MicrosystemsLab/PressureController/PrsCtrl_UI/waveform_list_all.txt

Waveform List
Constant,0 Hz,0 kPa,25 kPa,0 %,0.1 min
Sinusoid,1 Hz,5 kPa,25 kPa,0 %,0.1 min
Square,1 Hz,5 kPa,25 kPa,33 %,0.1 min
Ramp,1 Hz,5 kPa,25 kPa,0 %,0.1 min
