MicrosystemsLab/PressureController/system_diagram.png

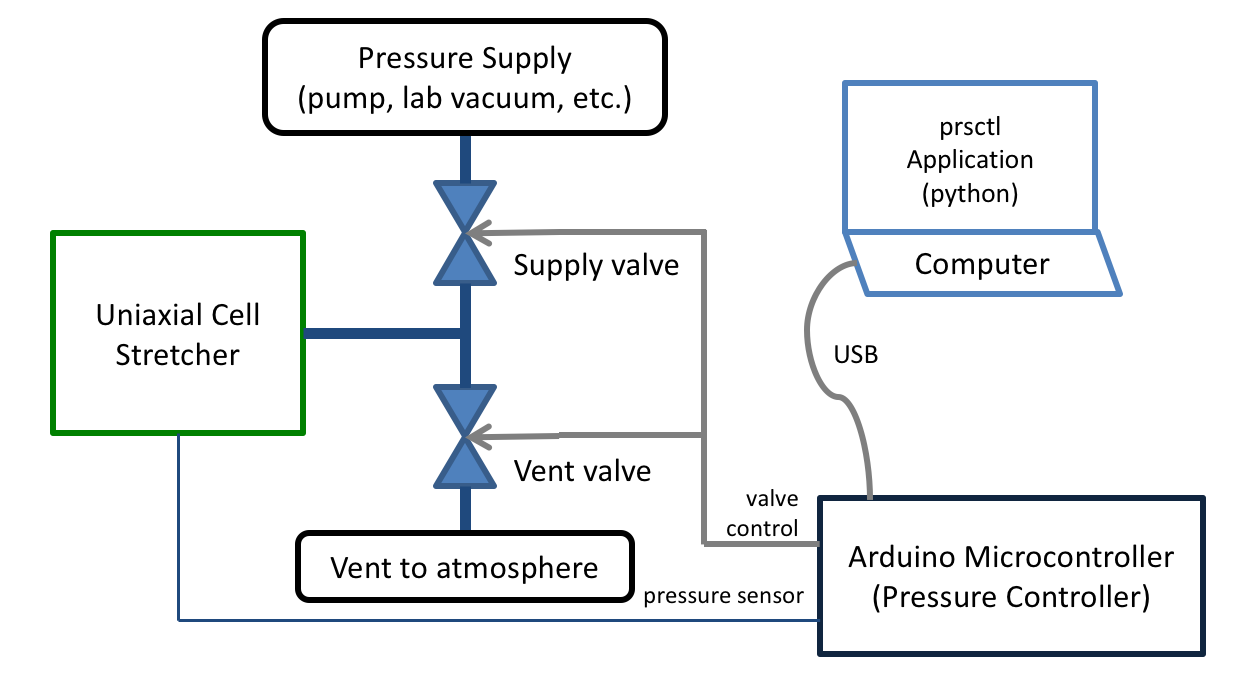
system_diagram.png
