MicrosystemsLab/PressureController/Circuit_Board/PC2_BOM.pdf

## Pressure Controller 2 BOM

Quantity | Image | Part Number | Description

Not included here: DC power supply (2.1 mm plug) and Arduino Uno microcontroller.

1

S1011EC-40-ND | CONN HEADER .100" SNGL STR 40POS
1050-1003-ND | BOX PLASTIC BLK 3.43"L X 2.52"W

1

2 | 24QBK-ND | RES 24 OHM 1/4W 5% AXIAL

2

399-4354-ND | CAP CER 0.22UF 50V Z5U RADIAL
IRLZ34NPBF-ND | MOSFET N-CH 55V 30A TO-220AB
160-1705-ND | LED RED DIFF 5MM ROUND T/H
399-9877-1-ND | CAP CER 0.1UF 50V X7R RADIAL
445-5263-ND | CAP CER 0.33UF 50V X7R RADIAL
3 | 1N4933GOS-ND | DIODE GEN PURP 50V 1A DO41

1

430QBK-ND | RES 430 OHM 1/4W 5% AXIAL
1.0MQBK-ND | RES 1M OHM 1/4W 5% AXIAL
CP-102A-ND | CONN PWR JACK 2X5.5MM SOLDER
ED2580-ND | TERM BLOCK 5.08MM VERT 2POS PCB

1

1

480-4489-ND | SENSOR PRESS 15PSID ANALOG
CL220N5-G-ND | IC LED DRIVER 220V .02A 3TO-220
360-3243-ND | SWITCH TOGGLE SPST 6A 125V

2

2 | 160-1703-ND | LED YELLOW DIFF 5MM ROUND T/H

1

1

2

1

1

1

2
