MicrosystemsLab/PressureController/Circuit_Board/PC2_circuit_v2p22.pdf

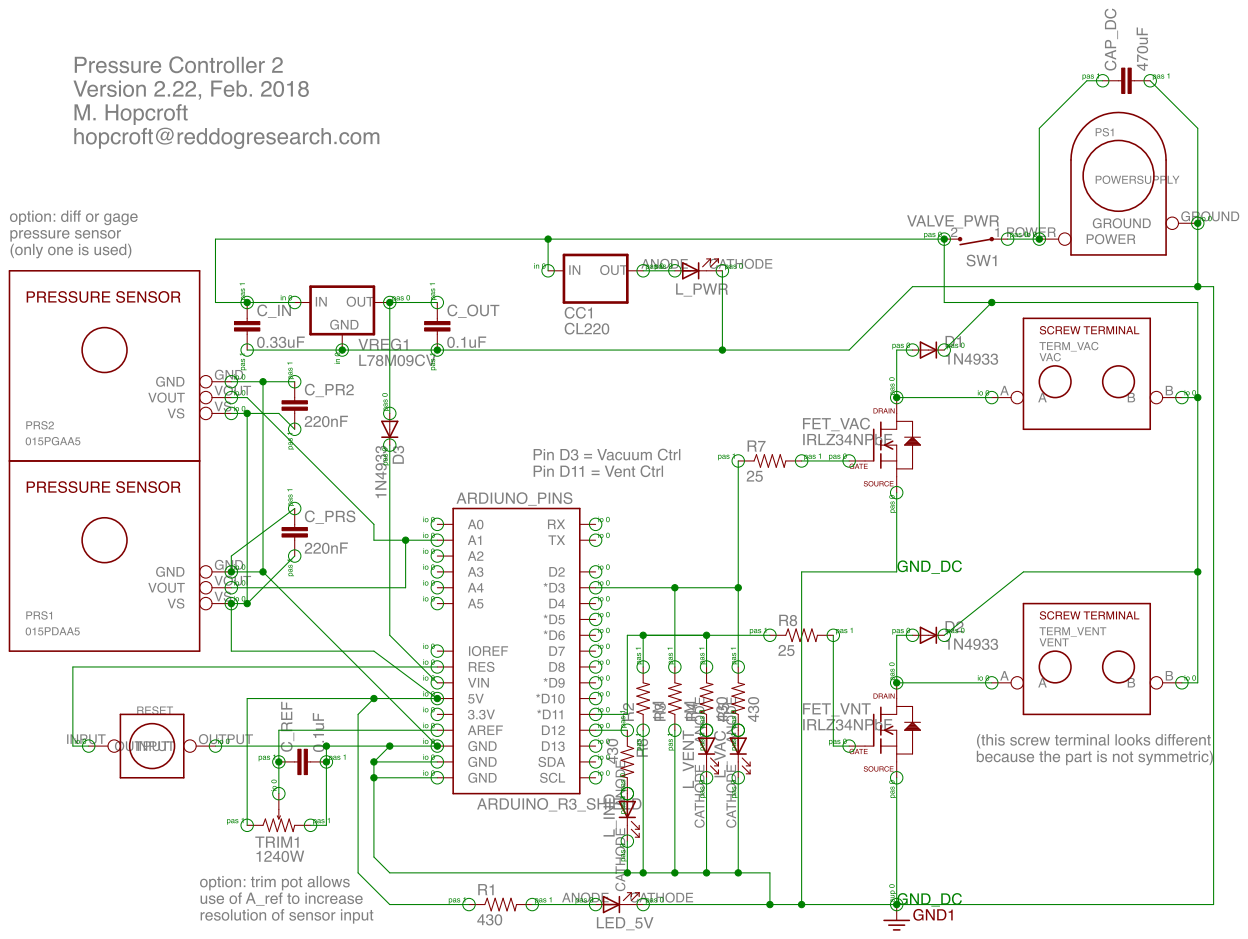
[picture p2: page 1]
