MicrosystemsLab/PressureController/Circuit_Board/PC2_pcb_v2p22.pdf

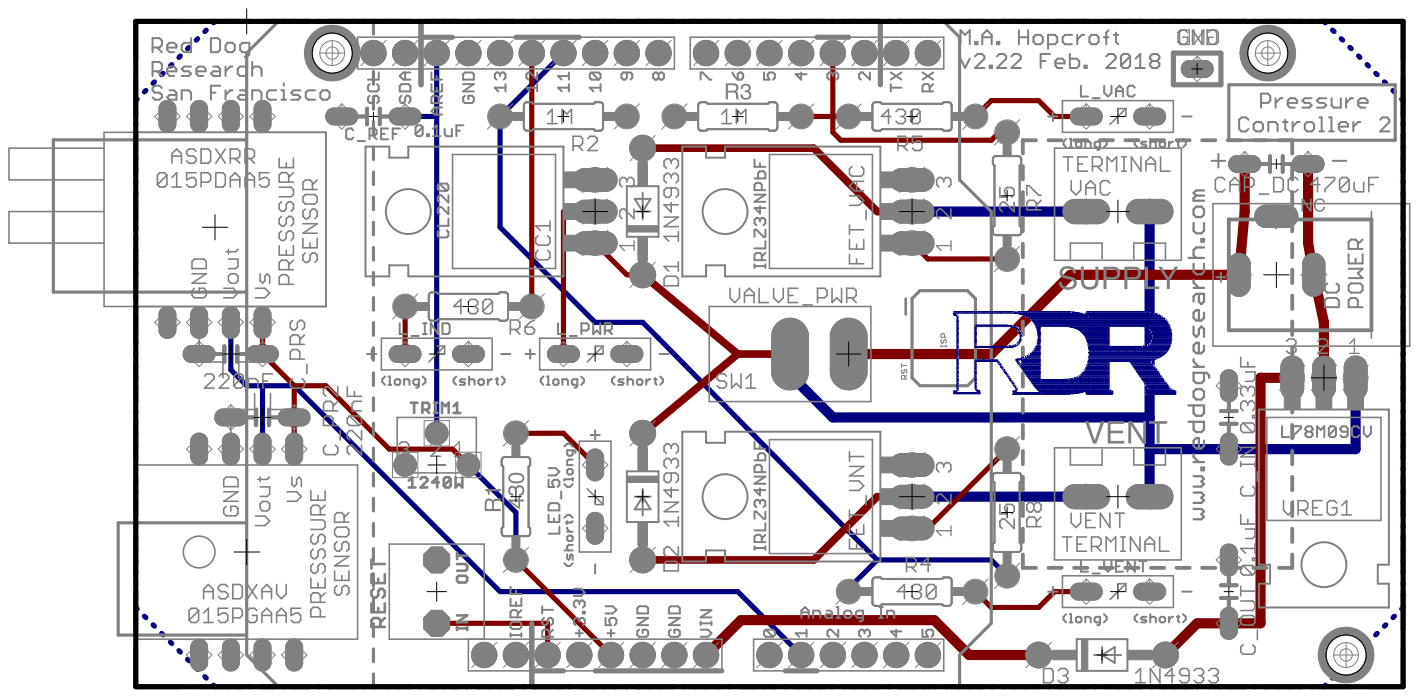
[picture p3: page 1]
