MicrosystemsLab/PressureController/(commit log)

2020-01-21 Upload PCB files
    [PC2_pcb_v2p22.drills.xln]
2020-02-23 add BOM for controller circuit board
